Protocentral/protocentral_max30003_hardware/hardware/protocentral-max30003-v3-schematic.pdf

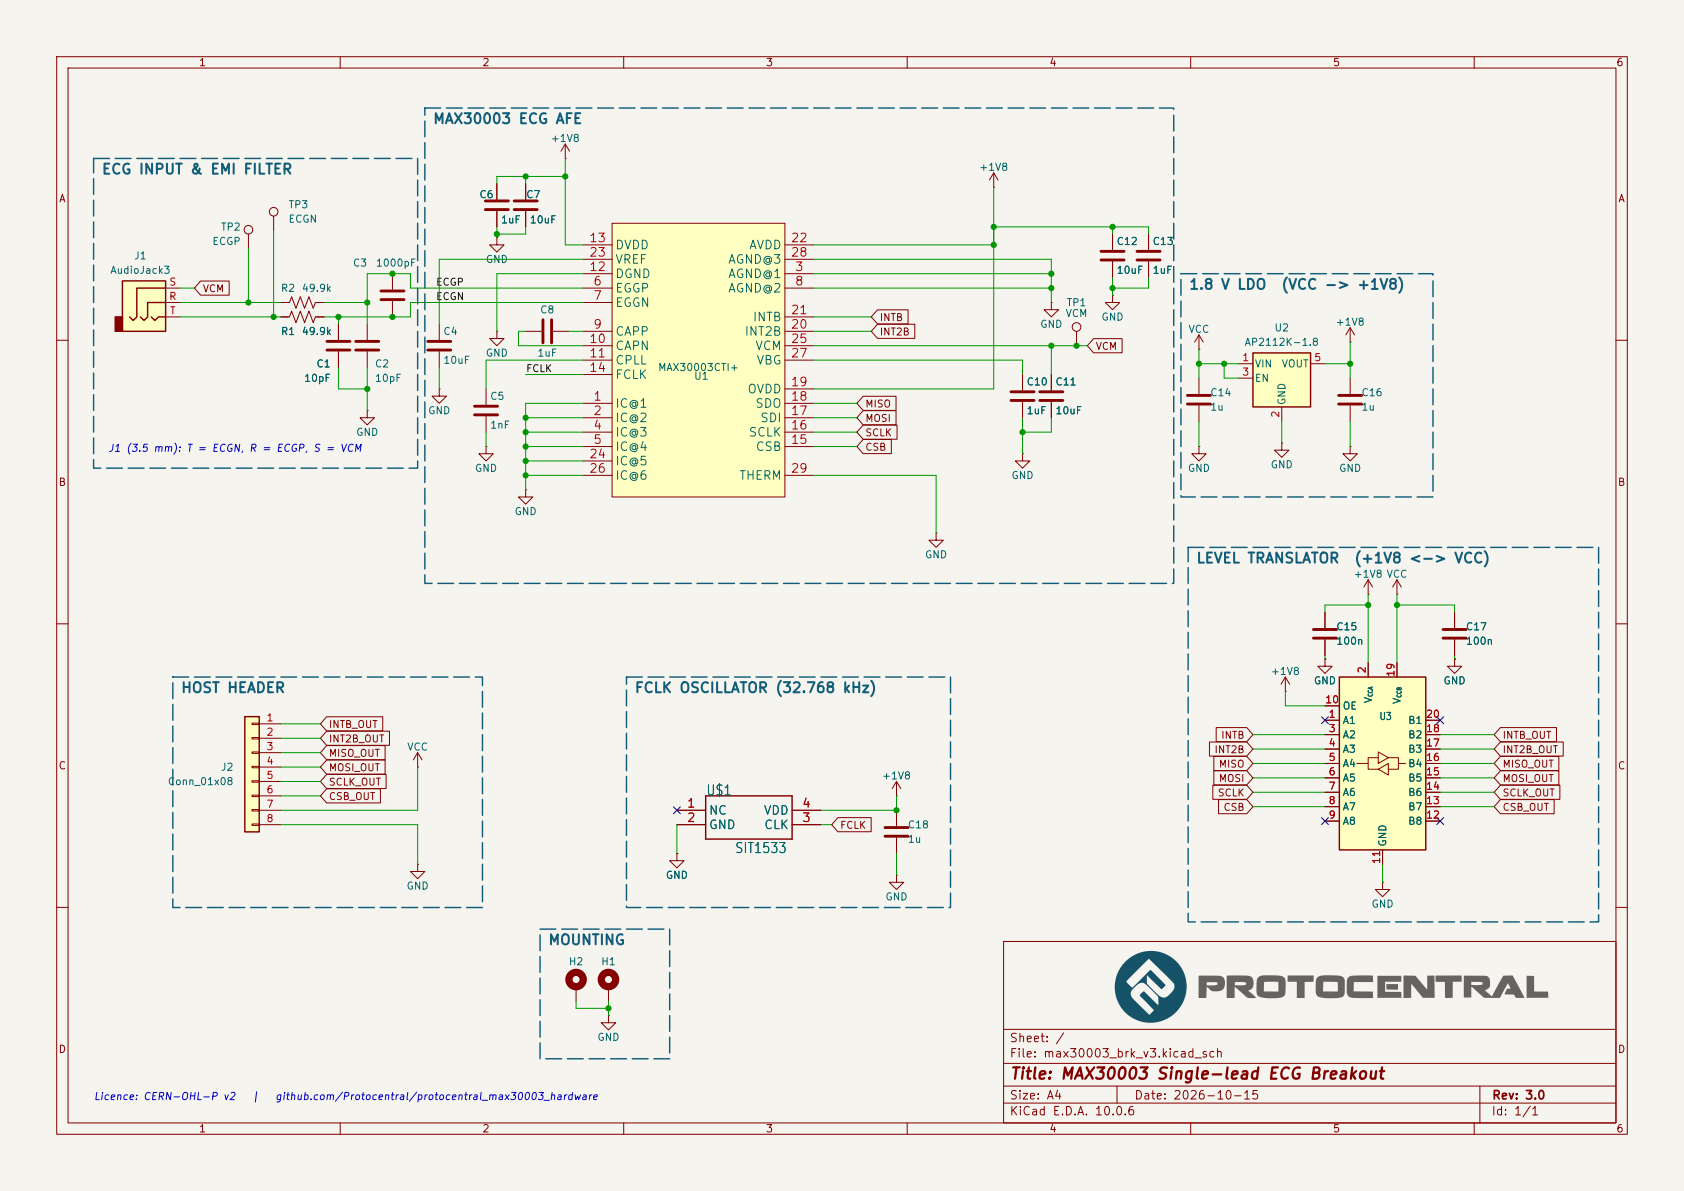
[picture p2: page 1]

ECG INPUT & EMI FILTER

J1 (3.5 mm): T = ECGN, R = ECGP, S = VCM

Sheet: /
File: max30003_brk_v3.kicad_sch
Title: MAX30003 Single-lead ECG Breakout

Licence: CERN-OHL-P v2 | github.com/Protocentral/protocentral_max30003_hardware

Size: A4 | Rev: 3.0
KiCad E.D.A. 10.0.6 | Id: 1/1
