Protocentral/protocentral_max30003_hardware/hardware/max30003_brk_v3.kicad_pcb

## KiCad design hardware/max30003_brk_v3.kicad_pcb (2026-10-15)

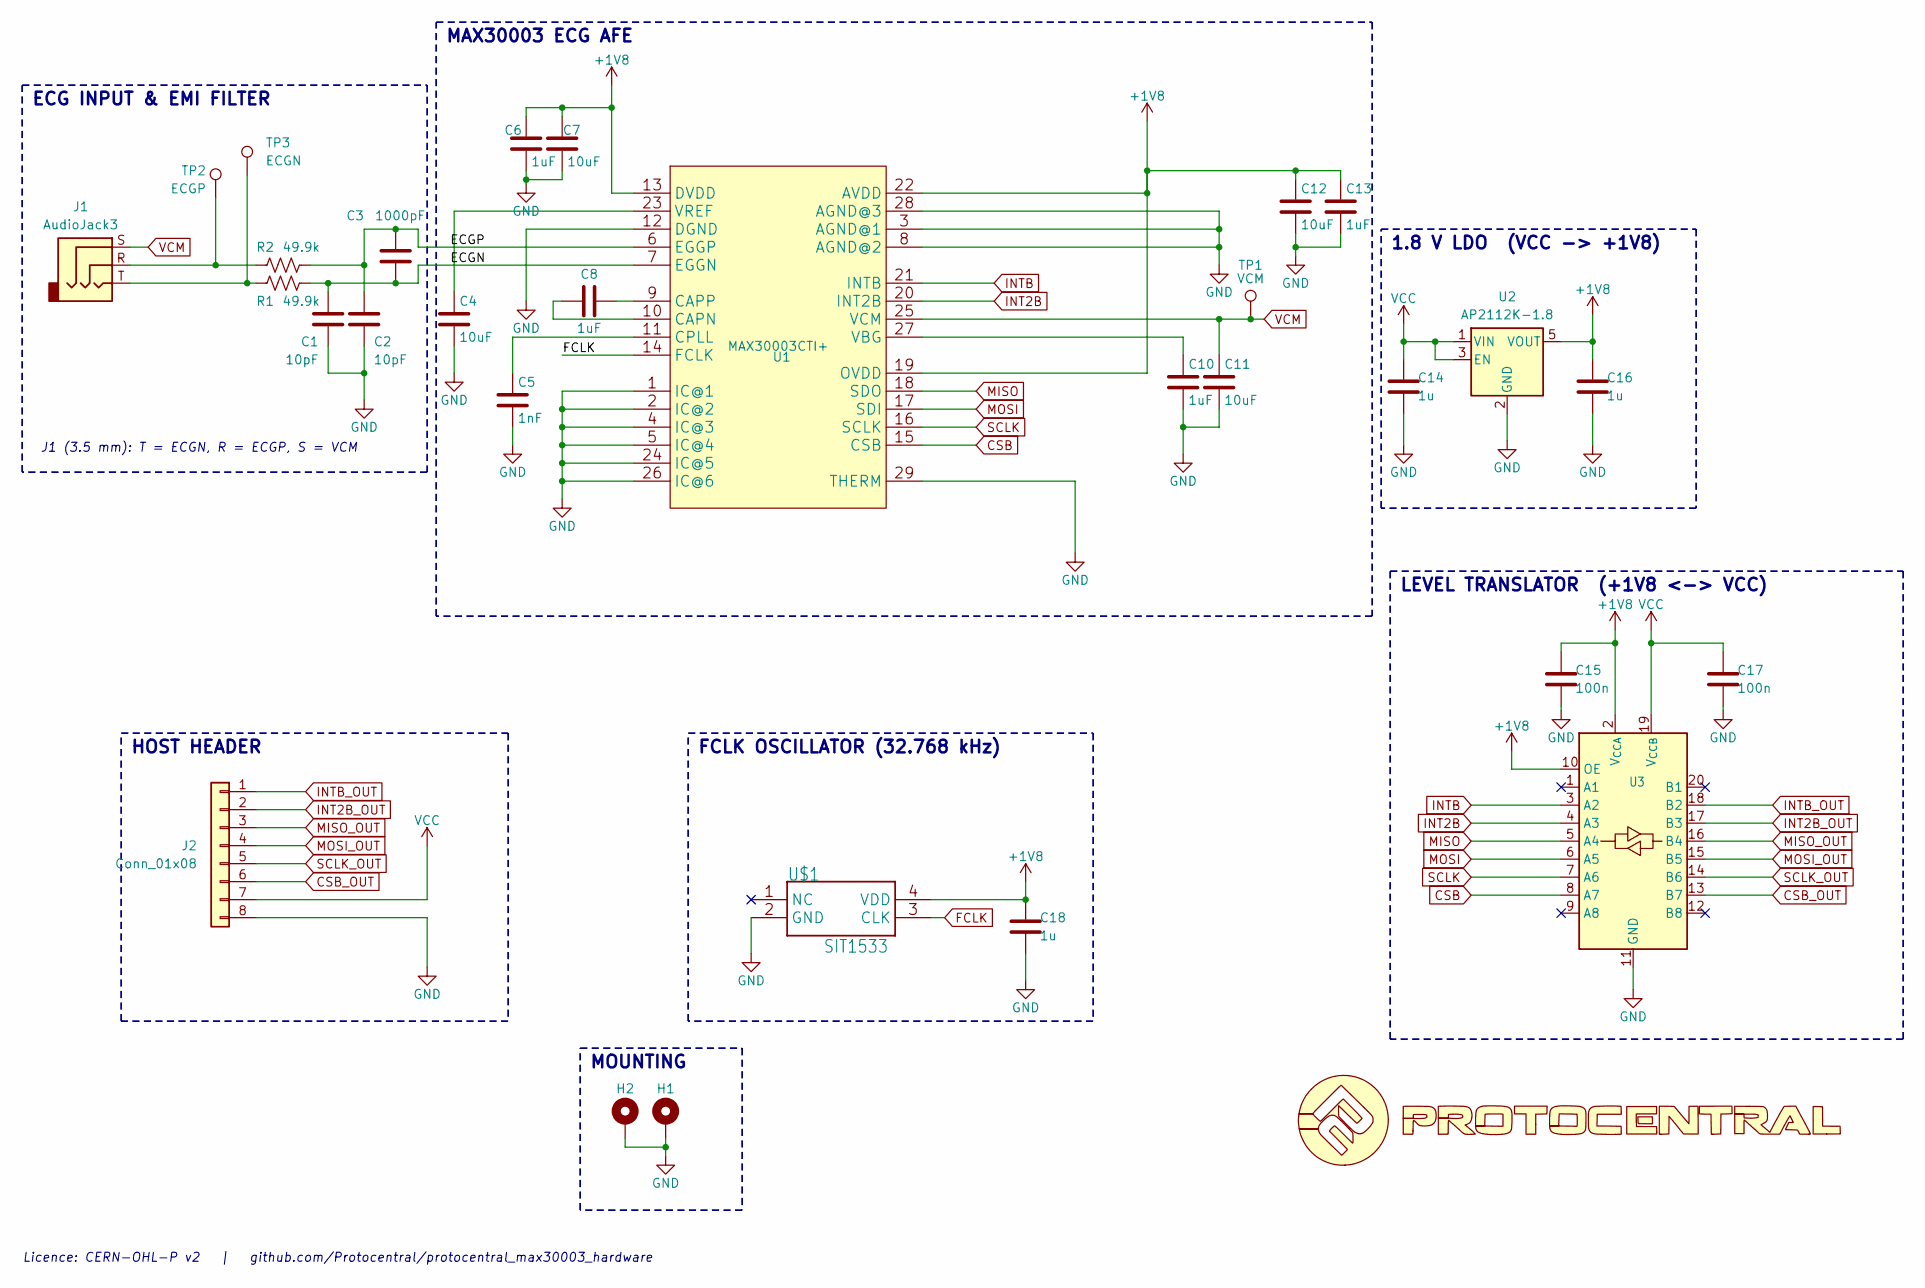
[picture p3: schematic max30003_brk_v3.kicad_sch, MAX30003 Single-lead ECG Breakout]

Parts:
C1, C2: 10pF; C_0402_1005Metric
C3: 1000pF; C_0402_1005Metric
C4: 10uF; C_0402_1005Metric
C5: 1nF; C_0402_1005Metric
C6, C8, C10, C13: 1uF; C_0402_1005Metric
C7, C11, C12: 10uF; C_0805_2012Metric
C14, C16, C18: 1u; C_0402_1005Metric
C15, C17: 100n; C_0402_1005Metric
H1, H2: MountingHole_Pad; MountingHole_2.2mm_M2_DIN965_Pad_TopBottom
J1: AudioJack3; Jack_3.5mm_CUI_SJ-3523-SMT_Horizontal
J2: Conn_01x08; PinHeader_1x08_P2.54mm_Vertical
R1, R2: 49.9k; R_0402_1005Metric
TP1: VCM; TestPoint_Pad_1.0x1.0mm
TP2: ECGP; TestPoint_Pad_1.0x1.0mm
TP3: ECGN; TestPoint_Pad_1.0x1.0mm
U1: MAX30003CTI+; QFN-28-1EP_5x5mm_P0.5mm_EP2.7x2.7mm
U2: AP2112K-1.8; SOT-23-5
U3: TXB0108PWR; TSSOP-20_4.4x6.5mm_P0.65mm
U4: LOGO
U$1: SIT1533; SiT1533_SIT

Connections:
+1V8: C6.1, C7.1, C12.1, C13.1, C15.2, C16.2, C18.2, U1.13 (DVDD), U1.19 (OVDD), U1.22 (AVDD), U2.5 (VOUT), U3.2 (V_{CCA}), U3.10 (OE), U$1.4 (VDD)
/ECGN: C1.1, C3.2, R1.2, U1.7 (EGGN)
/ECGP: C2.1, C3.1, R2.2, U1.6 (EGGP)
CSB: U1.15 (CSB), U3.8 (A7)
CSB_OUT: J2.6, U3.13 (B7)
FCLK: U1.14 (FCLK), U$1.3 (CLK)
GND: C1.2, C2.2, C4.2, C5.2, C6.2, C7.2, C10.2, C11.2, C12.2, C13.2, C14.1, C15.1, C16.1, C17.1, C18.1, H1.1 (1_1), H2.1 (1_1), J2.8, U1.1 (IC@1), U1.2 (IC@2), U1.3 (AGND@1), U1.4 (IC@3), U1.5 (IC@4), U1.8 (AGND@2), U1.12 (DGND), U1.24 (IC@5), U1.26 (IC@6), U1.28 (AGND@3), U1.29 (THERM), U2.2 (GND), U3.11 (GND), U$1.2 (GND)
INT2B: U1.20 (INT2B), U3.4 (A3)
INT2B_OUT: J2.2, U3.17 (B3)
INTB: U1.21 (INTB), U3.3 (A2)
INTB_OUT: J2.1, U3.18 (B2)
MISO: U1.18 (SDO), U3.5 (A4)
MISO_OUT: J2.3, U3.16 (B4)
MOSI: U1.17 (SDI), U3.6 (A5)
MOSI_OUT: J2.4, U3.15 (B5)
unnamed: J1.R, R2.1, TP2.1 (1_1)
unnamed: J1.T, R1.1, TP3.1 (1_1)
unnamed: C8.2, U1.10 (CAPN)
unnamed: C8.1, U1.9 (CAPP)
unnamed: C5.1, U1.11 (CPLL)
unnamed: C10.1, U1.27 (VBG)
unnamed: C4.1, U1.23 (VREF)
SCLK: U1.16 (SCLK), U3.7 (A6)
SCLK_OUT: J2.5, U3.14 (B6)
VCC: C14.2, C17.2, J2.7, U2.1 (VIN), U2.3 (EN), U3.19 (V_{CCB})
VCM: C11.1, J1.S, TP1.1 (1_1), U1.25 (VCM)

Notes on the sheet:
ECG INPUT & EMI FILTER
MAX30003 ECG AFE
1.8 V LDO (VCC -> +1V8)
HOST HEADER
FCLK OSCILLATOR (32.768 kHz)
LEVEL TRANSLATOR (+1V8 <-> VCC)
MOUNTING
J1 (3.5 mm): T = ECGN, R = ECGP, S = VCM
Licence: CERN-OHL-P v2 | github.com/Protocentral/protocentral_max30003_hardware

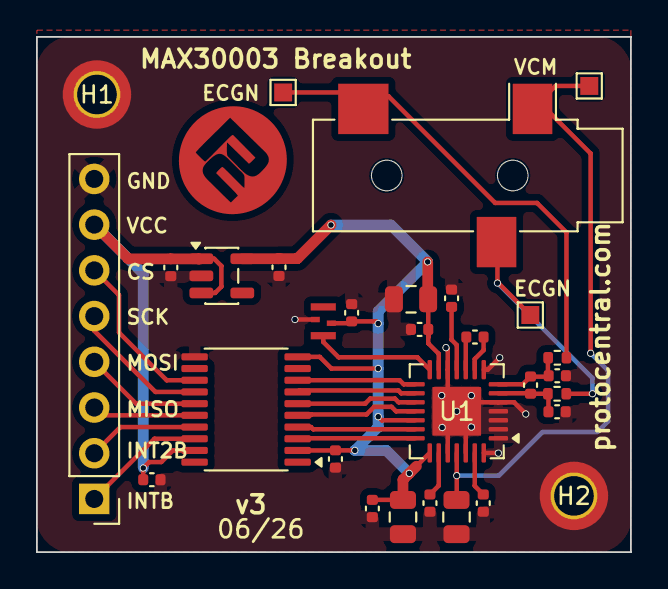
[picture p4: board max30003_brk_v3.kicad_pcb from above]

Board: 2 copper layers, 33.0 x 28.6 mm, 30 parts (0 on the bottom side), 26 nets.
