Protocentral/protocentral_max30003_hardware/hardware/previous-revisions/v2.0/pc_max30003_brk_v2.0.brd

## EAGLE design hardware/previous-revisions/v2.0/pc_max30003_brk_v2.0.brd (2026-10-15, an earlier design)

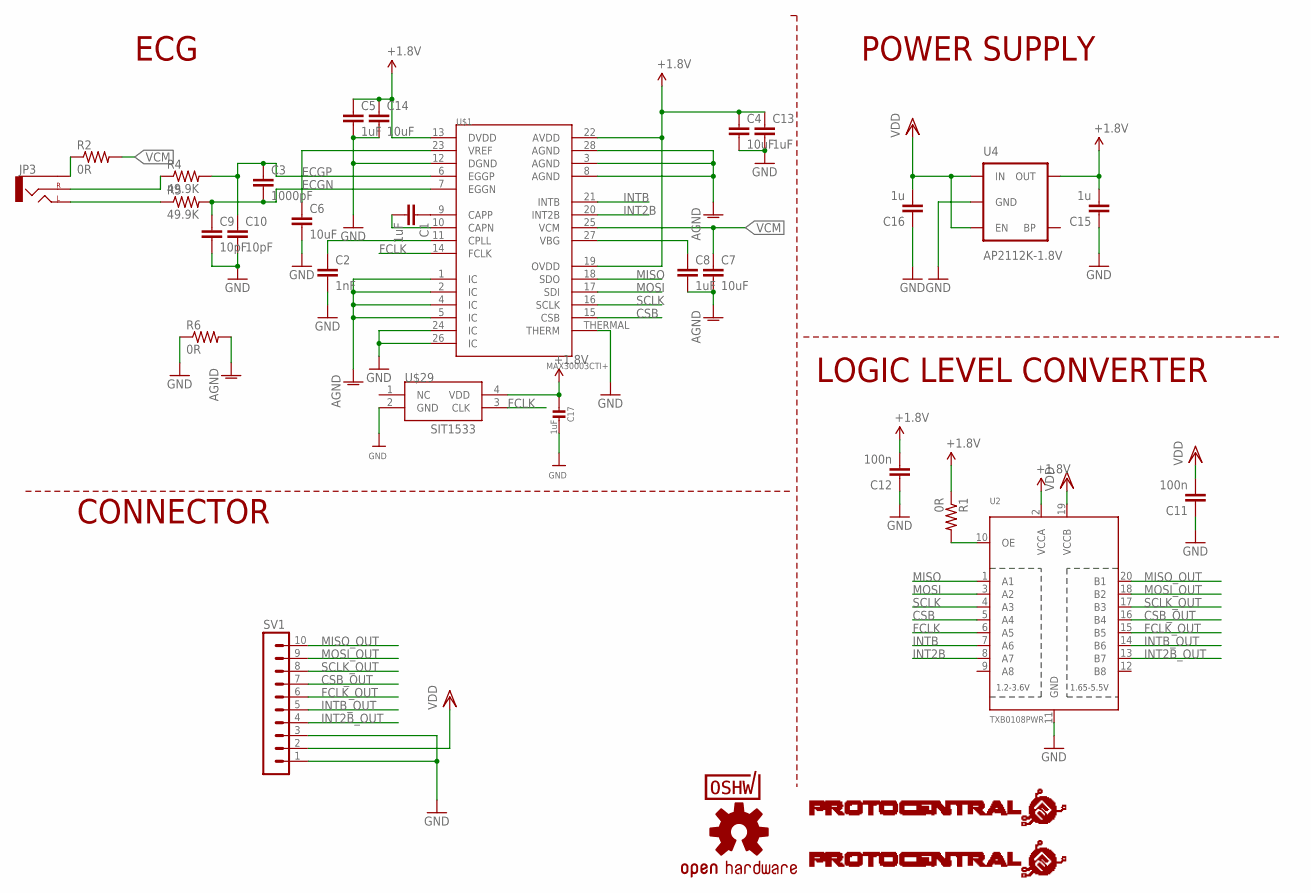
[picture p5: schematic pc_max30003_brk_v2.0.sch]

Parts:
C1, C5, C8, C13: 1uF; C0805
C2: 1nF; C0805
C3: 1000pF; C0402
C4, C6, C7, C14: 10uF; C0805
C9, C10: 10pF; C0402
C11, C12: 100n; C0402
C15, C16: 1u; C0805
C17: 1uF; _0402
JP3: AUDIO-JACKSMD2; AUDIO-JACK-3.5MM-SMD
R1, R2, R6: 0R; 0805
R4, R5: 49.9K; 0805
SV1: MA10-1
U2: TXB0108PWR; TSSOP20
U4: AP2112K-1.8V; SOT23-5
U$1: MAX30003CTI+; QFN-28
U$2: PROTY_LOGO_WITH_TEXT; PROTY_WITH_TEXT
U$3: PROTY-LOGO; LOGO-PROTY
U$6: OSHW-LOGOS; OSHW-LOGO-S
U$7: CERT-SMALL; CERT-SMALL-SILK
U$29: SIT1533

Connections:
+1.8V: C4.1, C5.1, C12.2, C13.1, C14.1, C15.2, C17.1, R1.1, U2.2 (VCCA), U4.5 (OUT), U$1.13 (DVDD), U$1.19 (OVDD), U$1.22 (AVDD), U$29.4 (VDD)
AGND: C7.2, C8.2, R6.2, U$1.1 (IC), U$1.2 (IC), U$1.3 (AGND), U$1.4 (IC), U$1.5 (IC), U$1.8 (AGND), U$1.28 (AGND)
CSB: U2.5 (A4), U$1.15 (CSB)
CSB_OUT: SV1.7, U2.16 (B4)
ECGN: C3.2, C9.1, R5.2, U$1.7 (EGGN)
ECGP: C3.1, C10.1, R4.2, U$1.6 (EGGP)
FCLK: U2.6 (A5), U$1.14 (FCLK), U$29.3 (CLK)
FCLK_OUT: SV1.6, U2.15 (B5)
GND: C2.2, C4.2, C5.2, C6.2, C9.2, C10.2, C11.1, C12.1, C13.2, C14.2, C15.1, C16.1, C17.2, R6.1, SV1.1, SV1.3, U2.11 (GND), U4.2 (GND), U$1.12 (DGND), U$1.24 (IC), U$1.26 (IC), U$1.THERMAL (THERM), U$29.2 (GND)
INT2B: U2.8 (A7), U$1.20 (INT2B)
INT2B_OUT: SV1.4, U2.13 (B7)
INTB: U2.7 (A6), U$1.21 (INTB)
INTB_OUT: SV1.5, U2.14 (B6)
MISO: U2.1 (A1), U$1.18 (SDO)
MISO_OUT: SV1.10, U2.20 (B1)
MOSI: U2.3 (A2), U$1.17 (SDI)
MOSI_OUT: SV1.9, U2.18 (B2)
unnamed: R1.2, U2.10 (OE)
unnamed: C6.1, U$1.23 (VREF)
unnamed: C1.1, U$1.9 (CAPP)
unnamed: JP3.SLEEVE, R2.1
unnamed: C1.2, U$1.10 (CAPN)
unnamed: C2.1, U$1.11 (CPLL)
unnamed: JP3.TIP (LEFT), R5.1
unnamed: JP3.RING (RIGHT), R4.1
unnamed: C8.1, U$1.27 (VBG)
SCLK: U2.4 (A3), U$1.16 (SCLK)
SCLK_OUT: SV1.8, U2.17 (B3)
VCM: C7.1, R2.2, U$1.25 (VCM)
VDD: C11.2, C16.2, SV1.2, U2.19 (VCCB), U4.1 (IN), U4.3 (EN)

Notes on the sheet:
ECG
POWER SUPPLY
LOGIC LEVEL CONVERTER
CONNECTOR

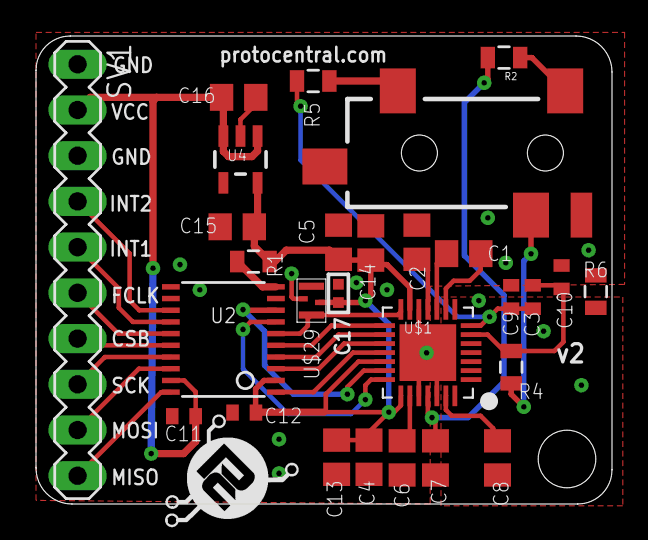
[picture p6: board pc_max30003_brk_v2.0.brd from above]

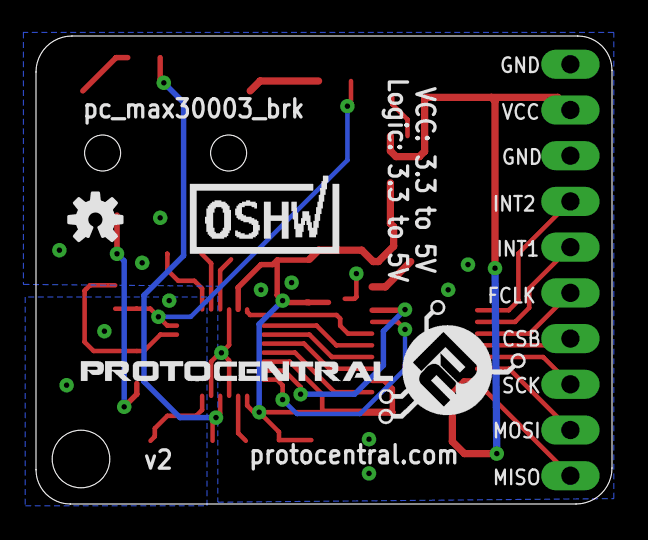
[picture p7: board pc_max30003_brk_v2.0.brd from below]

Board: 4 copper layers, 32.0 x 26.0 mm, 32 parts (3 on the bottom side), 30 nets.
